ale-giustina/CAN-serializer/production/CAN_SERIALIZER_V1_bom.csv

Designator | Footprint | Quantity | Value | LCSC Part #
C10, C12, C13, C14, C15, C16, C45, C46, C47, C48, C49, C50 | 0603 | 12 | 100nF | C14663
C11, C9 | 0603 | 2 | 20pF | C1648
C17 | 0805 | 1 | 100nF 16V | C49678
C18, C19 | 0805 | 2 | 10uF 16V | C15850
C20 | 0603 | 1 | 10uF | C19702
C33, C34, C35, C36, C37, C38, C39, C40, C41, C42, C43, C44 | 0603 | 12 | 15pF | C1644
D19, D20, D21 | SOT-23 | 3 | NUP2105L | C284104
D24, D25, D28, D29, D32, D33, D43, D44, D45, D46, D47, D48, D50, D51 | D_SOD-523 | 14 | TVS | C77807
D26, D27, D30, D31, D34, D35 | SOT-23 | 6 | BAT54S | C7420333
D37, D38, D39 | 0603 | 3 | RED LED | C965799
D40, D41, D42, D49 | 0603 | 4 | GREEN LED | C7496818
F1 | 1206 | 1 | 750mA Polyfuse | C7542952
FB1 | 0603 | 1 | FerriteBead | C80165
FL1, FL2, FL3 | ACT45B-xxx-2P-TL003 | 3 | ACT45B-101-2P-TL003 | C88056
J1, J8, J9 | PinHeader_1x02_P2.00mm_Vertical | 3 | Conn_01x02 | C376075
J2 | PinHeader_1x06_P2.54mm_Vertical | 1 | SPI connector | C37208
J3 | PinHeader_1x04_P2.54mm_Vertical | 1 | I2C connector | C124378
J4 | USB_C_Receptacle_XKB_U262-16XN-4BVC11 | 1 | USB_C_Receptacle_USB2.0_14P | C319148
J5 | SHDRRA7W83P0X381_1X7_2806X920X825P | 1 | CAN interfaces
J6 | PinHeader_1x04_P2.54mm_Vertical | 1 | USART2 connector | C124378
J7 | SAMTEC_FTSH-107-01-L-DV-K-TR | 1 | Debug | C22074484
R1, R15, R2, R23, R24, R5, R6, R7 | 0603 | 8 | 47R | C23182
R10, R11, R12, R13, R14, R22, R9 | 0603 | 7 | 680R | C23228
R16 | 0603 | 1 | 10kR | C25804
R17, R18 | 0603 | 2 | 5k1R | C14677
R19, R20, R21 | 0603 | 3 | 120R | C22787
R3, R4 | 0603 | 2 | 4k7R | C99782
R44, R45, R46, R47, R48, R49 | 0603 | 6 | 33R | C23140
SW2 | SW_SPST_FSMSM | 1 | RESET
U1 | SOT-23-6 | 1 | USBLC6-2SC6 | C2827654
U13, U14, U15 | SOIC-8_3.9x4.9mm_P1.27mm | 3 | MCP2562FD | C511335
U2 | LQFP-48_7x7mm_P0.5mm | 1 | STM32G473CCTx
U3 | SOT-223-3_TabPin2 | 1 | LD1117S33TR | C86781
Y2 | Crystal_SMD_EuroQuartz_MT-4Pin_3.2x2.5mm | 1 | 16MHz | C6190540
