ale-giustina/CAN-serializer/modelli/u262-16xn-4bvc11.stp

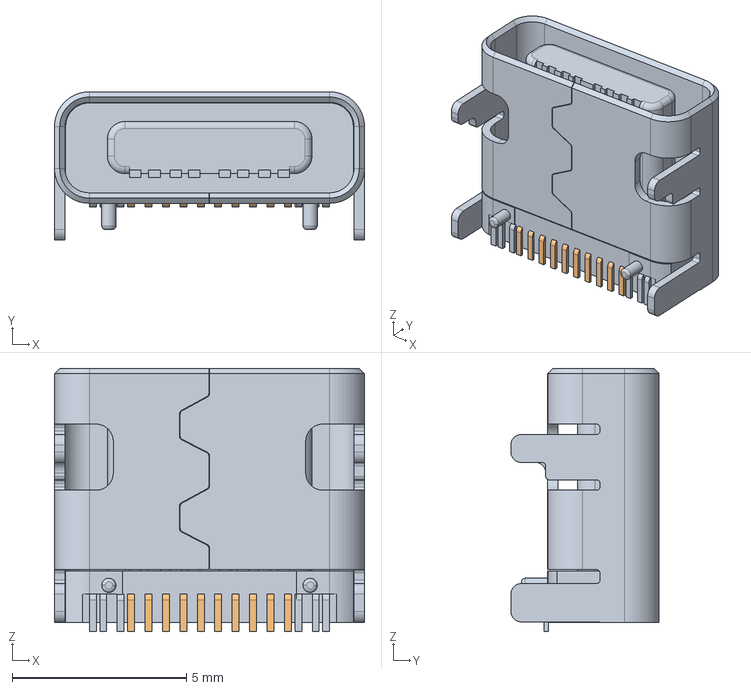
[picture p6: CAD file, 2026-10-13]
modelli/u262-16xn-4bvc11.stp
8.90 x 4.26 x 7.56 mm
