ale-giustina/CAN-serializer/CAN-serializer.kicad_pcb

## KiCad design CAN-serializer.kicad_pcb (2026-10-16)

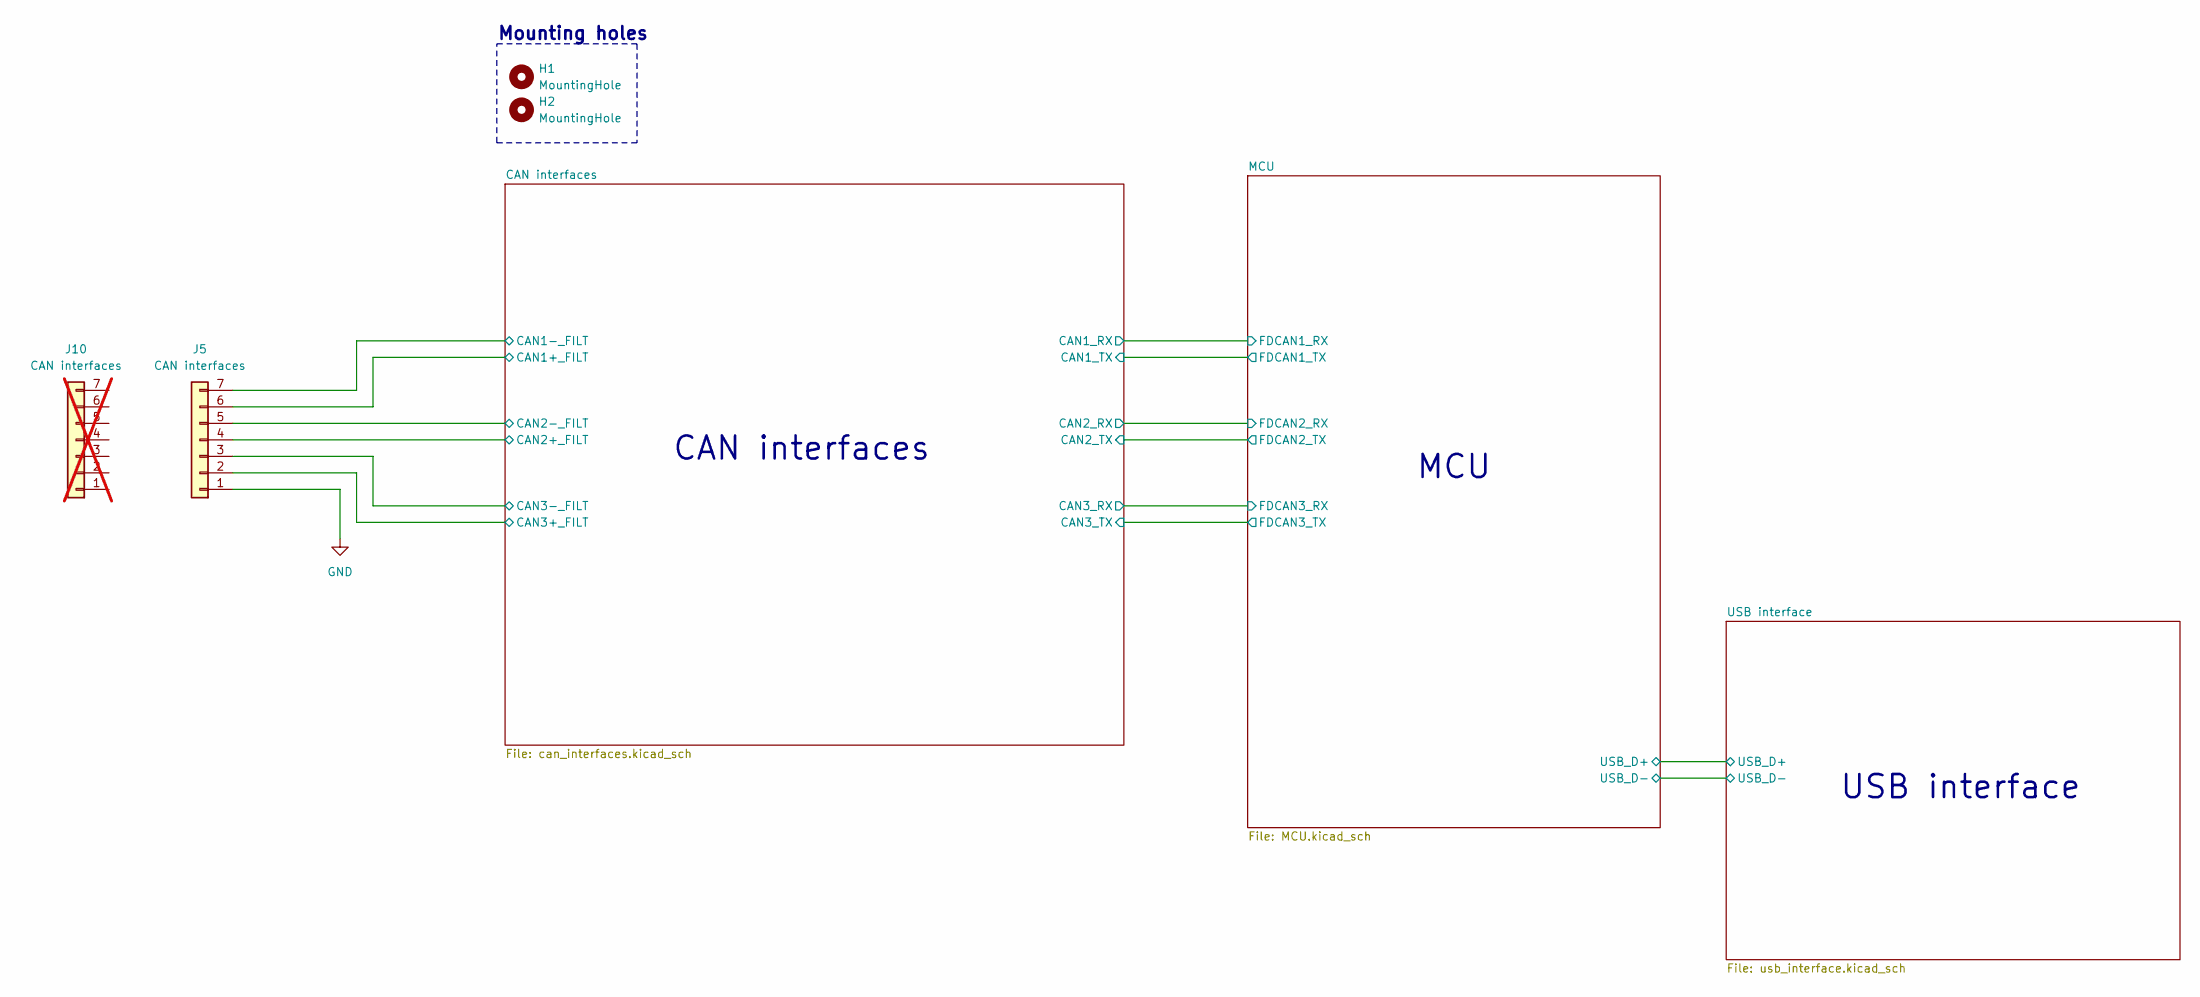
[picture p7: schematic CAN-serializer.kicad_sch]

Parts:
H1, H2: MountingHole; MountingHole_2.2mm_M2_ISO14580
J5: CAN interfaces; SHDRRA7W83P0X381_1X7_2806X920X825P; MOUSER PN 651-1803329
J10: CAN interfaces; 651-1848943; MOUSER PN 651-1848943; LCSC Part # 651-1848943; not fitted

Connections:
/CAN interfaces/CAN1+_FILT: J5.6; also elsewhere on the board
/CAN interfaces/CAN1-_FILT: J5.7; also elsewhere on the board
/CAN interfaces/CAN2+_FILT: J5.4; also elsewhere on the board
/CAN interfaces/CAN2-_FILT: J5.5; also elsewhere on the board
/CAN interfaces/CAN3+_FILT: J5.2; also elsewhere on the board
/CAN interfaces/CAN3-_FILT: J5.3; also elsewhere on the board
GND: J5.1; also elsewhere on the board

Notes on the sheet:
Mounting holes
USB interface
CAN interfaces
MCU

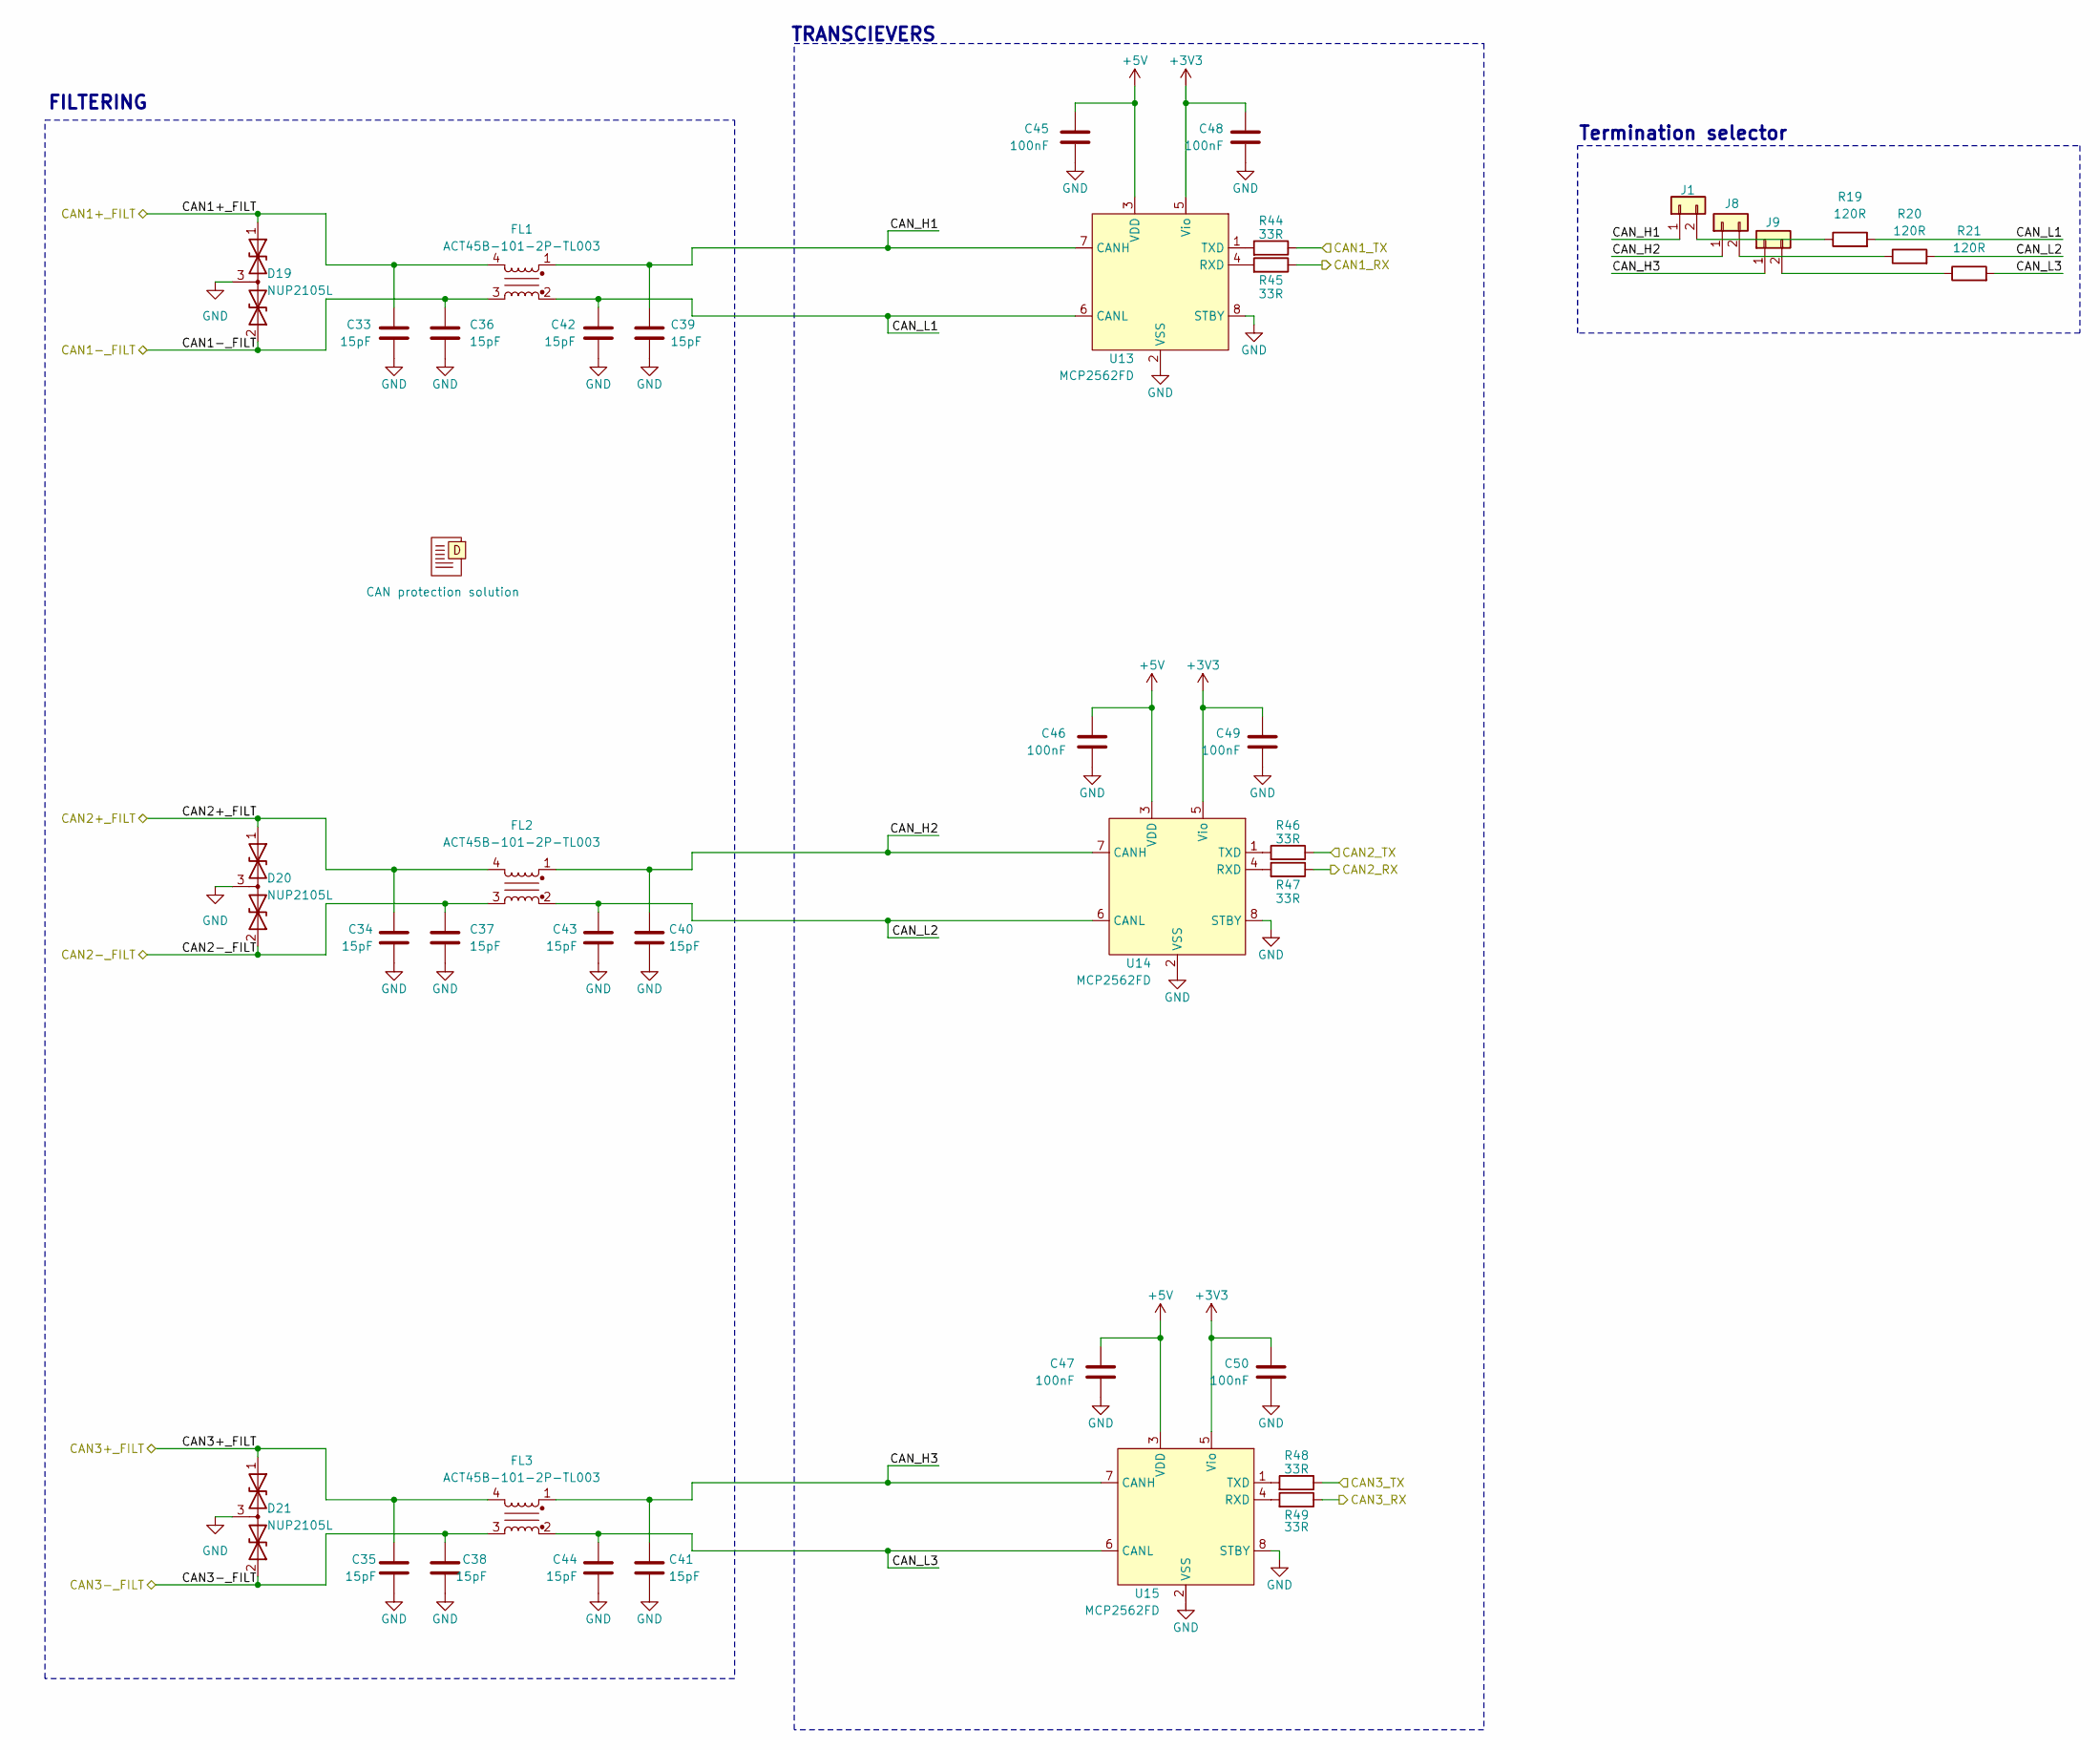
[picture p8: schematic can_interfaces.kicad_sch, Can-Serializer]

Parts:
C33, C34, C35, C36, C37, C38, C39, C40, C41, C42, C43, C44: 15pF; C_0603_1608Metric_Pad1.08x0.95mm_HandSolder; MOUSER PN 581-06031U150FAT2A; LCSC Part # C1644
C45, C46, C47, C48, C49, C50: 100nF; C_0603_1608Metric_Pad1.08x0.95mm_HandSolder; MOUSER PN 963-MAJCU168BB7104KT; LCSC Part # C14663
D19, D20, D21: NUP2105L; SOT-23; MOUSER PN 637-NUP2105L; LCSC Part # C284104
D22: CAN protection solution
FL1, FL2, FL3: ACT45B-101-2P-TL003; ACT45B-xxx-2P-TL003; MOUSER PN 810-ACT45B1012PTL003; LCSC Part # C88056
J1, J8, J9: Conn_01x02; PinHeader_1x02_P2.00mm_Vertical; LCSC Part # C376075
R19, R20, R21: 120R; R_0603_1608Metric_Pad0.98x0.95mm_HandSolder; MOUSER PN 652-CR0603-JW-121ELF; LCSC Part # C22787
R44, R45, R46, R47, R48, R49: 33R; R_0603_1608Metric_Pad0.98x0.95mm_HandSolder; MOUSER PN 603-AF0603JR-0733RL; LCSC Part # C23140
U13, U14, U15: MCP2562FD; SOIC-8_3.9x4.9mm_P1.27mm; MOUSER PN 579-MCP2562FD-H/SN; LCSC Part # C511335

Connections:
+3V3: C48.1, C49.1, C50.1, U13.5 (Vio), U14.5 (Vio), U15.5 (Vio); also elsewhere on the board
+5V: C45.1, C46.1, C47.1, U13.3 (VDD), U14.3 (VDD), U15.3 (VDD); also elsewhere on the board
/CAN interfaces/CAN1+_FILT: C33.1, D19.1 (A1), FL1.4; also elsewhere on the board
/CAN interfaces/CAN1-_FILT: C36.1, D19.2 (A2), FL1.3; also elsewhere on the board
/CAN interfaces/CAN1_RX: R45.1; also elsewhere on the board
/CAN interfaces/CAN1_TX: R44.1; also elsewhere on the board
/CAN interfaces/CAN2+_FILT: C34.1, D20.1 (A1), FL2.4; also elsewhere on the board
/CAN interfaces/CAN2-_FILT: C37.1, D20.2 (A2), FL2.3; also elsewhere on the board
/CAN interfaces/CAN2_RX: R47.1; also elsewhere on the board
/CAN interfaces/CAN2_TX: R46.1; also elsewhere on the board
/CAN interfaces/CAN3+_FILT: C35.1, D21.1 (A1), FL3.4; also elsewhere on the board
/CAN interfaces/CAN3-_FILT: C38.1, D21.2 (A2), FL3.3; also elsewhere on the board
/CAN interfaces/CAN3_RX: R49.1; also elsewhere on the board
/CAN interfaces/CAN3_TX: R48.1; also elsewhere on the board
/CAN interfaces/CAN_H1: C39.1, FL1.1, J1.1, U13.7 (CANH)
/CAN interfaces/CAN_H2: C40.1, FL2.1, J8.1, U14.7 (CANH)
/CAN interfaces/CAN_H3: C41.1, FL3.1, J9.1, U15.7 (CANH)
/CAN interfaces/CAN_L1: C42.1, FL1.2, R19.2, U13.6 (CANL)
/CAN interfaces/CAN_L2: C43.1, FL2.2, R20.2, U14.6 (CANL)
/CAN interfaces/CAN_L3: C44.1, FL3.2, R21.2, U15.6 (CANL)
GND: C33.2, C34.2, C35.2, C36.2, C37.2, C38.2, C39.2, C40.2, C41.2, C42.2, C43.2, C44.2, C45.2, C46.2, C47.2, C48.2, C49.2, C50.2, D19.3 (common), D20.3 (common), D21.3 (common), U13.2 (VSS), U13.8 (STBY), U14.2 (VSS), U14.8 (STBY), U15.2 (VSS), U15.8 (STBY); also elsewhere on the board
unnamed: J1.2, R19.1
unnamed: J8.2, R20.1
unnamed: J9.2, R21.1
unnamed: R45.2, U13.4 (RXD)
unnamed: R44.2, U13.1 (TXD)
unnamed: R47.2, U14.4 (RXD)
unnamed: R46.2, U14.1 (TXD)
unnamed: R49.2, U15.4 (RXD)
unnamed: R48.2, U15.1 (TXD)

Notes on the sheet:
TRANSCIEVERS
FILTERING
Termination selector

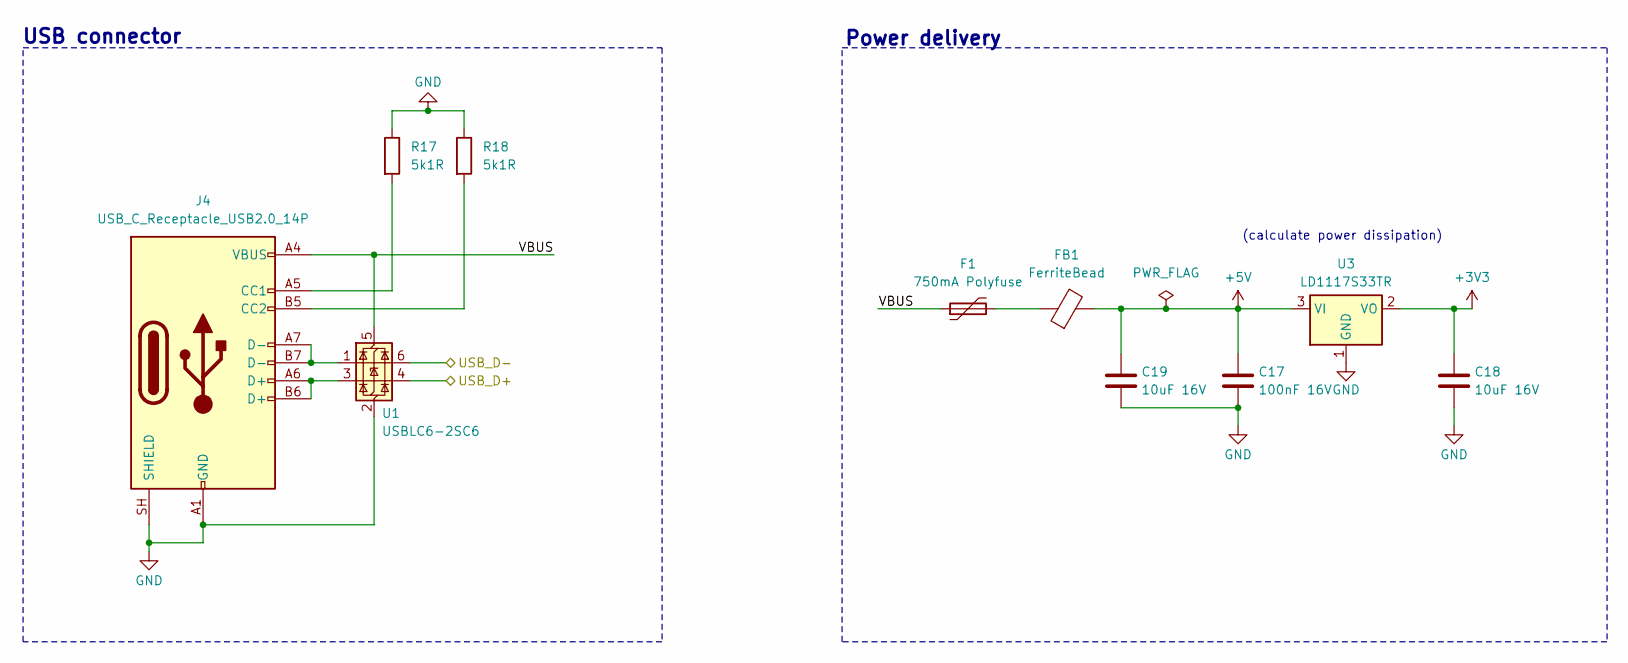
[picture p9: schematic usb_interface.kicad_sch]

Parts:
C17: 100nF 16V; C_0805_2012Metric_Pad1.18x1.45mm_HandSolder; MOUSER PN 581-0805YC104M4T2A; LCSC Part # C49678
C18, C19: 10uF 16V; C_0805_2012Metric_Pad1.18x1.45mm_HandSolder; MOUSER PN 603-CC0805MKX77BB106; LCSC Part # C15850
F1: 750mA Polyfuse; Fuse_1206_3216Metric_Pad1.42x1.75mm_HandSolder; MOUSER PN 576-1206L075SLYR; LCSC Part # C7542952
FB1: FerriteBead; L_0603_1608Metric; MOUSER PN 81-BLM18PG221SN1D; LCSC Part # C80165
J4: USB_C_Receptacle_USB2.0_14P; USB_C_Receptacle_XKB_U262-16XN-4BVC11; MOUSER PN 640-USB4105-GF-A; LCSC Part # C319148
R17, R18: 5k1R; R_0603_1608Metric_Pad0.98x0.95mm_HandSolder; MOUSER PN 603-RE0603FRE075K1L; LCSC Part # C14677
U1: USBLC6-2SC6; SOT-23-6; MOUSER PN 511-USBLC6-2SC6; LCSC Part # C2827654
U3: LD1117S33TR; SOT-223-3_TabPin2; MOUSER PN 511-LD1117S33; LCSC Part # C86781

Connections:
+3V3: C18.1, U3.2 (VO); also elsewhere on the board
+5V: C17.1, C19.1, FB1.2, U3.3 (VI); also elsewhere on the board
/MCU/USB_D+: U1.4 (I/O2); also elsewhere on the board
/MCU/USB_D-: U1.6 (I/O1); also elsewhere on the board
/USB interface/VBUS: F1.1, J4.A4 (VBUS), J4.A9 (VBUS), J4.B4 (VBUS), J4.B9 (VBUS), U1.5 (VBUS)
GND: C17.2, C18.2, C19.2, J4.A1 (GND), J4.A12 (GND), J4.B1 (GND), J4.B12 (GND), J4.SH (SHIELD), R17.1, R18.1, U1.2 (GND), U3.1 (GND); also elsewhere on the board
unnamed: F1.2, FB1.1
unnamed: J4.A5 (CC1), R17.2
unnamed: J4.B5 (CC2), R18.2
unnamed: J4.A6 (D+), J4.B6 (D+), U1.3 (I/O2)
unnamed: J4.A7 (D-), J4.B7 (D-), U1.1 (I/O1)

Notes on the sheet:
(calculate power dissipation)
USB connector
Power delivery

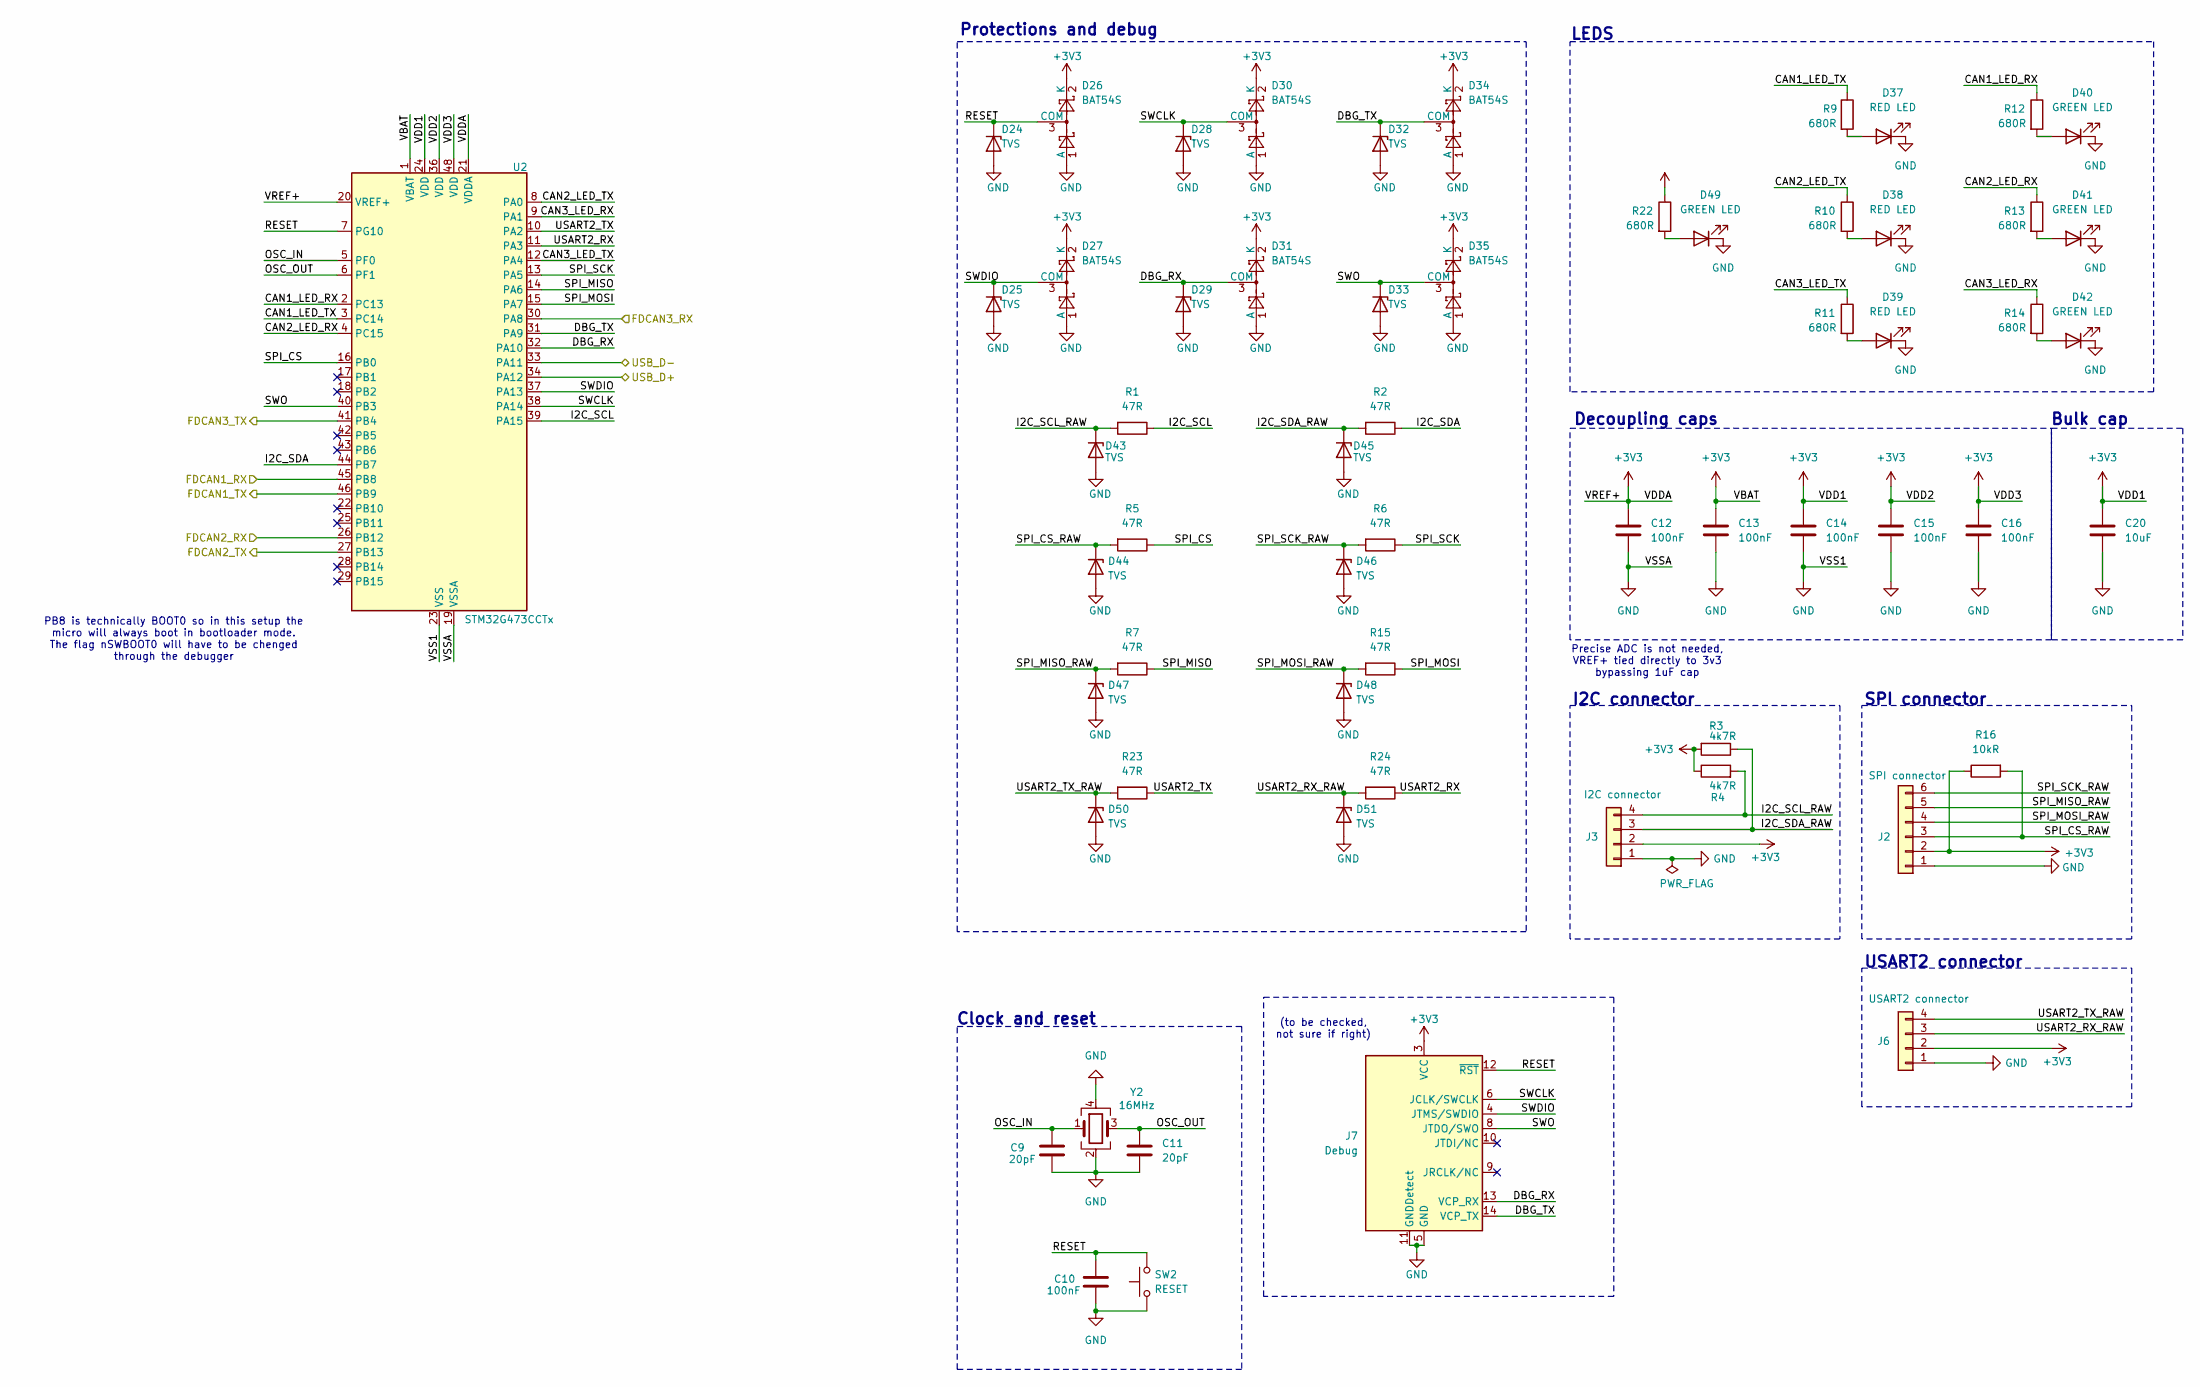
[picture p10: schematic MCU.kicad_sch, Can-Serializer]

Parts:
C9, C11: 20pF; C_0603_1608Metric_Pad1.08x0.95mm_HandSolder; MOUSER PN 581-06035A200GAT2A; LCSC Part # C1648
C10, C12, C13, C14, C15, C16: 100nF; C_0603_1608Metric_Pad1.08x0.95mm_HandSolder; MOUSER PN 963-MAJCU168BB7104KT; LCSC Part # C14663
C20: 10uF; C_0603_1608Metric_Pad1.08x0.95mm_HandSolder; MOUSER PN 581-KGM15CR51C106KT; LCSC Part # C19702
D24, D25, D28, D29, D32, D33, D43, D44, D45, D46, D47, D48, D50, D51: TVS; D_SOD-523; MOUSER PN 750-CPDH3V3UP; LCSC Part # C77807
D26, D27, D30, D31, D34, D35: BAT54S; SOT-23; MOUSER PN 863-SBAT54SLT1G; LCSC Part # C7420333
D37, D38, D39: RED LED; LED_0603_1608Metric_Pad1.05x0.95mm_HandSolder; MOUSER PN 604-APT1608SURCK-AMT; LCSC Part # C965799
D40, D41, D42, D49: GREEN LED; LED_0603_1608Metric_Pad1.05x0.95mm_HandSolder; MOUSER PN 720-Q65113A7469; LCSC Part # C7496818
J2: SPI connector; PinHeader_1x06_P2.54mm_Vertical; LCSC Part # C37208
J3: I2C connector; PinHeader_1x04_P2.54mm_Vertical; LCSC Part # C124378
J6: USART2 connector; PinHeader_1x04_P2.54mm_Vertical; LCSC Part # C124378
J7: Debug; SAMTEC_FTSH-107-01-L-DV-K-TR; MOUSER PN 200-FTSH10701LDVKTR; LCSC Part # C22074484
R1, R2, R5, R6, R7, R15, R23, R24: 47R; R_0603_1608Metric_Pad0.98x0.95mm_HandSolder; MOUSER PN 603-TR0603KR-0747RL; LCSC Part # C23182
R3, R4: 4k7R; R_0603_1608Metric_Pad0.98x0.95mm_HandSolder; MOUSER PN 603-AR0603JR-074K7L; LCSC Part # C99782
R9, R10, R11, R12, R13, R14, R22: 680R; R_0603_1608Metric_Pad0.98x0.95mm_HandSolder; MOUSER PN 667-ERA-3APB681V; LCSC Part # C23228
R16: 10kR; R_0603_1608Metric_Pad0.98x0.95mm_HandSolder; MOUSER PN 594-MCT06030D1002BPW; LCSC Part # C25804
SW2: RESET; SW_SPST_FSMSM; MOUSER PN 506-FSMSM
U2: STM32G473CCTx; LQFP-48_7x7mm_P0.5mm; MOUSER PN 511-STM32G473CCT3
Y2: 16MHz; Crystal_SMD_EuroQuartz_MT-4Pin_3.2x2.5mm; MOUSER PN 520-160-18-33-AENTR3; LCSC Part # C6190540

Connections:
+3V3: C12.1, C13.1, C14.1, C15.1, C16.1, C20.1, D26.2 (K), D27.2 (K), D30.2 (K), D31.2 (K), D34.2 (K), D35.2 (K), J2.2, J3.2, J6.2, J7.3 (VCC), R3.2, R4.1, R16.1, R22.1, U2.1 (VBAT), U2.20 (VREF+), U2.21 (VDDA), U2.24 (VDD), U2.36 (VDD), U2.48 (VDD); also elsewhere on the board
/CAN interfaces/CAN1_RX: U2.45 (PB8); also elsewhere on the board
/CAN interfaces/CAN1_TX: U2.46 (PB9); also elsewhere on the board
/CAN interfaces/CAN2_RX: U2.26 (PB12); also elsewhere on the board
/CAN interfaces/CAN2_TX: U2.27 (PB13); also elsewhere on the board
/CAN interfaces/CAN3_RX: U2.30 (PA8); also elsewhere on the board
/CAN interfaces/CAN3_TX: U2.41 (PB4); also elsewhere on the board
/MCU/CAN1_LED_RX: R12.1, U2.2 (PC13)
/MCU/CAN1_LED_TX: R9.1, U2.3 (PC14)
/MCU/CAN2_LED_RX: R13.1, U2.4 (PC15)
/MCU/CAN2_LED_TX: R10.1, U2.8 (PA0)
/MCU/CAN3_LED_RX: R14.1, U2.9 (PA1)
/MCU/CAN3_LED_TX: R11.1, U2.12 (PA4)
/MCU/DBG_RX: D29.1 (K), D31.3 (COM), J7.13 (VCP_RX), U2.32 (PA10)
/MCU/DBG_TX: D32.1 (K), D34.3 (COM), J7.14 (VCP_TX), U2.31 (PA9)
/MCU/I2C_SCL: R1.1, U2.39 (PA15)
/MCU/I2C_SCL_RAW: D43.1 (K), J3.4, R1.2, R4.2
/MCU/I2C_SDA: R2.1, U2.44 (PB7)
/MCU/I2C_SDA_RAW: D45.1 (K), J3.3, R2.2, R3.1
/MCU/OSC_IN: C9.1, U2.5 (PF0), Y2.1
/MCU/OSC_OUT: C11.1, U2.6 (PF1), Y2.3
/MCU/RESET: C10.1, D24.1 (K), D26.3 (COM), J7.12 (~RST), SW2.2, U2.7 (PG10)
/MCU/SPI_CS: R5.1, U2.16 (PB0)
/MCU/SPI_CS_RAW: D44.1 (K), J2.3, R5.2, R16.2
/MCU/SPI_MISO: R7.1, U2.14 (PA6)
/MCU/SPI_MISO_RAW: D47.1 (K), J2.5, R7.2
/MCU/SPI_MOSI: R15.1, U2.15 (PA7)
/MCU/SPI_MOSI_RAW: D48.1 (K), J2.4, R15.2
/MCU/SPI_SCK: R6.1, U2.13 (PA5)
/MCU/SPI_SCK_RAW: D46.1 (K), J2.6, R6.2
/MCU/SWCLK: D28.1 (K), D30.3 (COM), J7.6 (JCLK/SWCLK), U2.38 (PA14)
/MCU/SWDIO: D25.1 (K), D27.3 (COM), J7.4 (JTMS/SWDIO), U2.37 (PA13)
/MCU/SWO: D33.1 (K), D35.3 (COM), J7.8 (JTDO/SWO), U2.40 (PB3)
/MCU/USART2_RX: R24.1, U2.11 (PA3)
/MCU/USART2_RX_RAW: D51.1 (K), J6.3, R24.2
/MCU/USART2_TX: R23.1, U2.10 (PA2)
/MCU/USART2_TX_RAW: D50.1 (K), J6.4, R23.2
/MCU/USB_D+: U2.34 (PA12); also elsewhere on the board
/MCU/USB_D-: U2.33 (PA11); also elsewhere on the board
GND: C9.2, C10.2, C11.2, C12.2, C13.2, C14.2, C15.2, C16.2, C20.2, D24.2 (A), D25.2 (A), D26.1 (A), D27.1 (A), D28.2 (A), D29.2 (A), D30.1 (A), D31.1 (A), D32.2 (A), D33.2 (A), D34.1 (A), D35.1 (A), D37.1 (K), D38.1 (K), D39.1 (K), D40.1 (K), D41.1 (K), D42.1 (K), D43.2 (A), D44.2 (A), D45.2 (A), D46.2 (A), D47.2 (A), D48.2 (A), D49.1 (K), D50.2 (A), D51.2 (A), J2.1, J3.1, J6.1, J7.5 (GND), J7.7 (GND), J7.11 (GNDDetect), SW2.1, U2.19 (VSSA), U2.23 (VSS), U2.35 (VSS), U2.47 (VSS), Y2.2 (G), Y2.4; also elsewhere on the board
unnamed: D37.2 (A), R9.2
unnamed: D38.2 (A), R10.2
unnamed: D39.2 (A), R11.2
unnamed: D40.2 (A), R12.2
unnamed: D41.2 (A), R13.2
unnamed: D42.2 (A), R14.2
unnamed: D49.2 (A), R22.2

Notes on the sheet:
SPI connector
Protections and debug
USART2 connector
LEDS
Decoupling caps
Clock and reset
I2C connector
(to be checked, not sure if right)
PB8 is technically BOOT0 so in this setup the micro will always boot in bootloader mode. The flag nSWBOOT0 will have to be chenged through the debugger
Precise ADC is not needed, VREF+ tied directly to 3v3 bypassing 1uF cap
Bulk cap

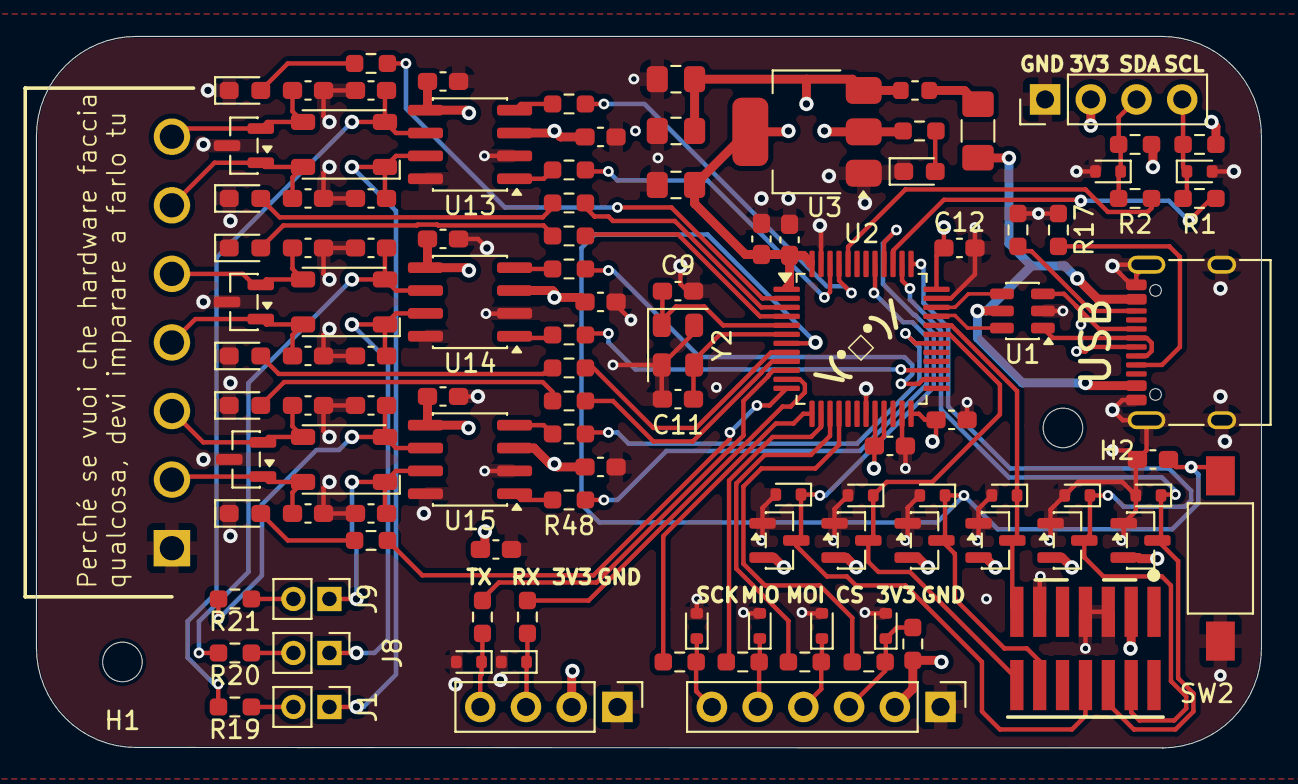
[picture p11: board CAN-serializer.kicad_pcb from above]

Board: 4 copper layers, 68.1 x 39.5 mm, 113 parts (0 on the bottom side), 75 nets.
