ale-giustina/CAN-serializer/code.ioc

Mcu.UserName=STM32G473CCTx
PA0.GPIO_Label=CAN2_LED_TX
PA0.Signal=GPIO_Output
PA1.GPIO_Label=CAN3_LED_RX
PA1.Signal=GPIO_Output
PA10.Signal=USART1_RX
PA11.Signal=USB_DM
PA12.Signal=USB_DP
PA13.Signal=SYS_JTMS-SWDIO
PA14.Signal=SYS_JTCK-SWCLK
PA15.Signal=I2C1_SCL
PA2.Signal=USART2_TX
PA3.Signal=USART2_RX
PA4.GPIO_Label=CAN3_LED_TX
PA4.Signal=GPIO_Output
PA5.Signal=SPI1_SCK
PA6.Signal=SPI1_MISO
PA7.Signal=SPI1_MOSI
PA8.Signal=FDCAN3_RX
PA9.Signal=USART1_TX
PB0.GPIO_Label=SPI_CS
PB0.Signal=GPIO_Output
PB12.Signal=FDCAN2_RX
PB13.Signal=FDCAN2_TX
PB3.Signal=SYS_JTDO-SWO
PB4.Signal=FDCAN3_TX
PB7.Signal=I2C1_SDA
PB8-BOOT0.Signal=FDCAN1_RX
PB9.Signal=FDCAN1_TX
PC13.GPIO_Label=CAN1_LED_RX
PC13.Signal=GPIO_Output
PC14-OSC32_IN.GPIO_Label=CAN1_LED_TX
PC14-OSC32_IN.Signal=GPIO_Output
PC15-OSC32_OUT.GPIO_Label=CAN2_LED_RX
PC15-OSC32_OUT.Signal=GPIO_Output
PF0-OSC_IN.Signal=RCC_OSC_IN
PF1-OSC_OUT.Signal=RCC_OSC_OUT
