ale-giustina/CAN-serializer/(commit log)

2026-10-13 Add project files
    [CAN-serializer.kicad_pcb, CAN-serializer.kicad_sch, MCU.kicad_sch, can_interfaces.kicad_sch, u262-16xn-4bvc11.stp, untitled.kicad_sch, usb_interface.kicad_sch]
2026-10-13 feat: added vias and traces config
    [CAN-serializer.kicad_pcb]
2026-10-13 feat: added vias
    [CAN-serializer.kicad_pcb, MCU.kicad_sch, usb_interface.kicad_sch]
2026-10-13 feat: finished vias
    [CAN-serializer.kicad_pcb, CAN-serializer.kicad_sch, usb_interface.kicad_sch]
2026-10-13 feat: finished first prototype
    [CAN-serializer.kicad_pcb]
2026-10-14 feat: started writing BOM
    [CAN-serializer.kicad_pcb, CAN-serializer.kicad_sch, CAN_SERIALIZER_V1_bom.csv, CAN_SERIALIZER_V1_designators.csv, CAN_SERIALIZER_V1_positions.csv, MCU.kicad_sch, can_interfaces.kicad_sch, usb_interface.kicad_sch]
2026-10-15 feat: finished BOM
    [CAN-serializer.kicad_pcb, MCU.kicad_sch, usb_interface.kicad_sch]
2026-10-16 feat: first batch
    [CAN-serializer.kicad_pcb, CAN_SERIALIZER_V1_designators.csv]
2026-10-16 feat: added .ioc
    [CAN-serializer.kicad_pcb, untitled.kicad_sch]
2026-10-17 Add sample .ioc file information to README
    Added information about the sample .ioc file for CUBEMX configuration.
2026-11-10 chore: update readme with assembled images
